niceworkkiimm-ai/gimbal-inspection-rover/THIRD_PARTY_NOTICES.md

# 第三方来源与许可

- `project/Library`：STMicroelectronics STM32F4 标准外设驱动。各文件保留原始版本、版权及 MCD-ST Liberty SW License 声明；请按原声明使用。
- `project/Start`：ARM CMSIS 与 ST 启动、系统和器件头文件；各文件内原许可证优先。
- `project/three.min.js`：Three.js Authors，文件内声明 MIT / SPDX-License-Identifier: MIT。
- `project/OrbitControls.umd.js`：Three.js OrbitControls 的本地 UMD 适配文件，按对应 Three.js MIT 许可理解；保留已有文件注释。
- Arduino ESP8266 Core 3.1.2、Arduino ESP32 Core 3.3.11 通过开发板管理器安装；本仓库不上传 Core 压缩包、编译器或 SDK 构建缓存，各依赖沿用其自身许可证。

仓库保留项目原有文件，并未宣称第三方驱动、字体、示例和网页库为原创。没有为整个混合项目新增统一的再授权许可证。
