niceworkkiimm-ai/gimbal-inspection-rover/docs/publication.md

# 首次公开整理记录

日期：2026-10-08。

## 范围

- 独立仓库 `niceworkkiimm-ai/gimbal-inspection-rover`，不使用工创仓库。
- 基于当前工作工程：STM32 V8.13、基座 ESP V4.9、NodeMCU 手持 V1.6、ESP32-CAM V1.2、网页 V8.12。
- 首次选择性同步收录 215 个源码/文档/必要资源文件，另生成 6 份公开密码配置示例。
- 保留原目录；逐文件校验选中原文件同步前后的 SHA-256 一致。包含个人路径的说明在公开副本中使用占位，旧 Git 历史不导入。
- 原源码中的 6 处 Wi-Fi 密码配置在发布副本中提取为未跟踪的 `secrets.h`，原件不改动。
- 排除编译产物、SDK 压缩包、IDE 状态、缓存、报告截图和私有配置；保留现有驱动与网页依赖的版权注释。
- 增加 README、依赖清单、开发对话/工程交接摘要，以及 D 盘一键同步备份工具。

## 验证

- 同步第二次执行为 0 变更，选中原文件哈希保持一致。
- Keil 完整重编译：0 Error(s)、0 Warning(s)。
- Arduino ESP8266 Core 3.1.2：基座、手持编译通过；Arduino ESP32 Core 3.3.11：AI Thinker 摄像头编译通过。
- ESP32 首次在中文构建路径下链接失败，改用 D 盘英文构建目录后通过；未因此修改固件功能代码。
- 现有扫描快照测试：7 passed、0 failed。
- 两个主要网页的外部脚本依赖存在，内嵌脚本及根目录 JavaScript 语法检查通过。
- 私有配置、密码头文件和生成的编译文件被 Git 忽略；发布脚本在提交前再次检查暂存区。

这次验证不执行硬件烧录，不代替实际供电、PCB 接线、运动方向、传感器或图传的实机测试。
