niceworkkiimm-ai/gimbal-inspection-rover/project/V7.1_路线记录与补传说明.md

# V7.1 路线记录与补传

更新日期：2026-09-12。STM32 V7.1，基座 ESP V4.7，手持端保持原版本。

## 这次解决什么

以前网页收到编码器数据后才计算路线，Wi-Fi 中断、浏览器暂停或基座重启可能让中间采样丢失。现在由 STM32 持续计算路线，网页按记录编号分批读取；短时断网恢复后，自动补回仍在缓存中的真实记录，不把未知路段简单画成直线。

- STM32 主循环至少间隔 40 ms 计算一次，至少间隔 80 ms 留一条记录。
- 内存保存最近 1024 条，按 80 ms 计算约 82 秒；实际覆盖时间随主循环采样间隔变化。
- 缓存满后覆盖最早记录。恢复通信和追赶积压也需要时间，不应把 82 秒当作保证可恢复的断网时长。
- 2D/3D 页面都支持，保存和打开仍用原来的按钮。雷达量程、方向、扫描点功能不变。
- 基座单独重启时，只要 STM32 持续运行且缓存未覆盖，仍可补传。
- 主控重启、缓存覆盖、主控采样异常仍明确留缺口，不能保证任何情况下路线都完整。
- 这只是编码器里程估算，不是定位建图；轮子打滑产生的误差不能靠补传消除。

## 更新哪些设备

1. 用本目录的 `Gimbal_STLink.uvprojx` 重新编译并烧录 STM32。
2. 用本目录的 `ESP01S_Base_UDP/ESP01S_Base_UDP.ino` 重新编译并烧录基座 ESP-01S。
3. 手持端不用重新烧录，所有接线不变，没有新增引脚，PD3 仍不接。
4. 重新打开本目录 `gimbal-radar-standalone.html` 或 `gimbal-3d-scan.html`。保留整个目录，不要单独复制 HTML；新增的 `route-log.js` 和原有脚本都需要一起保留。

上电后请核对网页标定：轮径 97 mm、左右轮中心距 202 mm、前后轮中心距 210 mm、每圈 374 次、四轮方向依次为 `+ - + -`，并确认标定。与固件不一致时网页拒绝接纳新路线，不能只在网页改尺寸就让固件跟着改变。

## 使用与保存

1. 连上基座热点，再打开网页；首次打开或点击重新记录，从当前位置开始，不追溯刚打开前的缓存路程。
2. 页面出现“车端记录已同步”后，手动驾驶记录路线。
3. 短时断网时保持页面打开，不刷新、不关闭、不重新记录。恢复连接后等待补传完成。
4. 停车，等待“车端记录已同步”，再点“保存路线”。首次保存选择桌面的“路径保存数据库”文件夹；不支持文件夹选择的浏览器需在下载记录确认文件，并放到该文件夹。
5. 之后可离线使用“打开路线”查看保存的 JSON。主控重启不会删除已经保存到电脑的文件。

主控缓存只是 RAM，不是永久数据库。网页刷新会丢失当前补传游标并开始新记录；主控断电会丢失其缓存。未保存的路线不能保证在关闭网页后恢复。

旧文件仍能打开，但本次更新无法找回旧文件已经缺失的实际路段。要自动复走，请重新记录完整路线；有缺口、会话重启或绘制简化的路线仍会被自动复走检查拒绝。

旧版基座没有新接口时，页面退回原编码器接收方式，可继续显示，但不具备这次新增的车端补传能力。

## 建议测试顺序

1. 四轮架空、车架固定，确认手动前后/转向和松手停车仍正常，观察编码器和 RPM。
2. 在空旷安全场地低速手控走短路线，停车保存，再打开，确认路径一致。
3. 保持手持端和基座连接，只让电脑断开热点约 10 至 30 秒，手控低速走一小段后停车。电脑重新连接，保持同一网页，等待同步完成，再检查并保存。
4. 可分别检查单独打开 2D、单独打开 3D、同时打开两个页面。两页各自有记录起点和补传进度，不要求显示坐标完全相同。

自动行驶仍受原有网页心跳、手持链路、主循环超时和前方测距保护。缓存能存约 80 秒，绝不意味着自动驾驶失联后允许继续行驶 80 秒。保护停车后不会自动恢复驾驶。

## 验证边界

已完成主控编译、基座编译，以及记录、缓存覆盖、断网重试、重复批次、会话切换、保存打开和控制保护的电脑模拟测试。测试不能代替实车验证；尚未替你烧录，也未实测主循环最大耗时、真实 Wi-Fi 丢包率或车辆循迹精度。
