niceworkkiimm-ai/gimbal-inspection-rover/project/V8.11_路线扫描点保存与回看.md

# V8.11 路线扫描点保存与回看

本次仅更新 2D/3D 网页。车辆路线上的红点保存停车位置对应的当前扫描点图，可点击回看，并随路线 JSON 一起保存和重新打开。

## 使用步骤

1. 在线连接车辆，停车并扫描到所需点图。保存前需有新鲜的路线和扫描数据，且原生路线记录同步完成。
2. 点击路线面板的“保存当前扫描点”，在当前路线位置生成红点。
3. 点击红点回看对应点图；3D 快照可旋转查看，两个页面均可打开。关闭回看窗口后继续查看现场。
4. 点击“保存路线”，将包含路线和扫描快照的 JSON 写入所选目录，或按浏览器提示下载。
5. 使用“打开路线”载入文件，恢复路线红点和点图，再点击红点回看。

2D、3D 页面均支持上述功能。打开历史文件后，点击“返回实时”可回到本次在线路线。

快照是保存时网页当前显示的扫描缓存，不是对“一次完整扫描已完成”的自动判定；保存前请确认画面就是需要保留的内容。3D 扫描会累积点云，到新点位后可先用现有“清空点云”再扫描；这不会删除已保存的路线红点。新红点先保留在浏览器内，关闭网页前请点击“保存路线”写入文件。

## 文件和范围

- 新路线 JSON 使用 `version: 2`，包含扫描快照；不保证旧版网页能读取新格式。
- 旧 `version: 1` 路线仍可打开，原文件没有的扫描快照不会被补造。
- 每条路线最多保存 100 个扫描点位，每点最多 800 个扫描采样；路线 JSON 文件上限为 20 MB。
- CSV 仍只导出路线，不包含扫描快照。
- 红点位置来自编码器路线估算，不是全局建图定位。该功能不包含气体或图传存档，也不恢复按保存路线自动行驶。

## 更新与接线

| 部分 | 本次版本 | 操作 |
| --- | --- | --- |
| 2D/3D 网页 | V8.11 | 替换网页及配套脚本后刷新 |
| STM32 | V8.10 | 无需烧录；`User/main.c` 仅更新顶部迭代注释 |
| 基座 ESP | V4.9 | 无需烧录 |
| 手持 NodeMCU | V1.6 | 无需烧录 |
| ESP32CAM_Camera | V1.2 | 无需烧录 |

已核对原固件接线，本次没有硬件改动。基座与 STM32 仍使用 **UART4：PC10 TX、PC11 RX，115200/8N1**；`User/main.c` 中完整接线表、供电说明及 `FIRMWARE_VERSION "V8.10"` 保持原样。电机、编码器、摇杆方向不变，无需重新标定实车方向。

## 验证范围

- Node 检查：7 组通过，覆盖快照独立副本、JSON 保存/打开、旧文件兼容、格式与容量边界、离线/未同步拒绝、重新开始。
- 浏览器本地模拟：2D/3D 捕获与回看、路线红点点击、3D 旋转、关闭/Escape、含快照文件保存、2D 页面断网打开并查看 3D 快照、返回实时和离线禁止新增均通过。
- 测试数据与测试文件写入服务仅在本机，未连接车辆；本次未进行实车验证或任何设备烧录。
- 可运行 `node tests/route-snapshot.test.cjs` 复查文件格式与数据边界。
