niceworkkiimm-ai/gimbal-inspection-rover/project/V8.5_图传10帧与上下翻转.md

# V8.5 · 图传10帧与上下翻转

更新：2026-09-13。摄像头V1.2；2D/3D网页V8.5。STM32 V8.2、基座ESP V4.8、手持V1.2不变。

## 怎么更新

1. 在Arduino IDE重新打开同一个 **ESP32CAM_Camera/ESP32CAM_Camera.ino**，防止IDE里仍留着旧内容。
2. Board保持 **AI Thinker ESP32-CAM**，Flash Mode=DIO、Flash Frequency=40MHz、Partition Scheme=Huge APP。接线与上次成功烧录时一样。
3. 点击 **Upload**，上传完成后IO0松开，按一下RST。只烧录摄像头，不烧STM32、基座或手持端。
4. Serial Monitor选115200。开头应显示 **Rover camera V1.2 / ESP32-CAM / QVGA / max 10 fps**。
5. 上下翻转日志 **Vertical flip requested: 1; result: 0 (0=OK); horizontal mirror: 0** 表示驱动接受配置；仍要对照实物确认方向。
6. 刷新原工程的gimbal-radar-standalone.html或gimbal-3d-scan.html，确认版本V8.5。图传窗口位置不变。
7. 关闭画面后，帧率选 **10 帧/秒**，再开启。原来已保存的5或3帧偏好不会被清除；首次使用默认10帧。摄像头地址继续用当前串口Camera URL。
8. 摄像头自己的独立查看页也支持10/5/3帧，并显示V1.2。一个窗口开启视频即可。

摄像头依赖文件CameraConfig.h、CameraHome.h继续与ino放在一起。网页的camera-panel.js继续与HTML放在同一个文件夹，不要只复制HTML。

## 改了什么

- 摄像头限速从200ms改为100ms，上限10帧/秒；/status的maxFps同步为10。
- 两页共用窗口及独立页面新增10帧选项，保留5/3帧。
- 10帧档网页至少105ms请求一次，留调度余量，理想情况下约9.5帧/秒，实际受曝光、信号、传输和解码耗时影响；不是保证稳定10帧。
- 摄像头CAMERA_VFLIP从0改为1，只上下翻转。CAMERA_HMIRROR仍为0，左右不变。不在网页做第二次翻转。
- 分辨率仍320×240，JPEG质量18；摄像头接线、热点、Arduino板型不变。
- 单查看者、每次只取一张、默认关闭、超时/过期清空、后台关闭机制保留。慢的时候等待本次完成，不积压请求追赶帧率。
- 摄像头固件版本1.2，HTTP接口版本仍1.0，原协议兼容。
- 主函数开头版本与接线复核说明已更新；全部电源、TFT、MPU、手持、基座、电机、编码器及传感器实际接线保留。
- 小车、云台、气体数据、路线记录/复走等控制代码不变。

## 使用提醒

帧率变高会增加共用ESP8266热点的流量，并不保证遥控更快。先停车检查画面方向，再有人看护下低速对比。手控变卡就先停车、关闭画面，降到5或3帧后重试。提高帧率不等于降低所有端到端延迟，也不新增自动停车功能。

## 电脑验证

- Arduino-ESP32 3.3.11 / AI Thinker ESP32-CAM正式编译与链接通过，未报告警告或错误。
- 应用1,058,629字节，全局变量59,832字节；不是运行时内存用量。
- 静态核对：STM32执行代码、实际硬件接线及两个网页的扫描逻辑不变；仅图传配置与版本更新。
- 已完成两页电脑/手机及独立页面的模拟JPEG收图回归：10帧默认项、启停、单请求、占用/限流、错误接口、重复/过期/损坏帧、超时、后台关闭通过。
- 2D、3D、独立页面各10/5/3帧共9组频率检查通过，历史帧率偏好保留正常；模拟350ms慢请求时始终只有1个请求在途，没有补发积压。详见D盘缓存测试结果。
- 未自动烧录。上下翻转的实际方向、真实10帧档表现、与手控共用热点时的稳定性仍需设备测试。

接线与Arduino操作详见V8.4_ESP32-CAM烧录与接线.md；其中V1.1和5帧数值为旧版记录，以本说明及当前源代码为准。研究、编译、测试缓存放在D盘，不需要用其中的工具来烧录；用户继续只用Arduino IDE。
