niceworkkiimm-ai/gimbal-inspection-rover/project/ESP32S3_Camera/历史版本_当前实物不要烧录.md

# 当前实物不要使用此文件夹

2026-09-13 已根据照片及烧录器识别确认：用户实物为普通 ESP32-CAM（ESP-32S），烧录底板为 ESP32-CAM-MB / CH340C。

本文件夹为此前依据 ESP32-S3CAM 资料生成的历史源码和固件，目标芯片及摄像头引脚不匹配，不能烧进当前板子。不要使用强制忽略芯片型号的参数。

请返回上一级，打开 **ESP32CAM_Camera/ESP32CAM_Camera.ino**（摄像头 V1.1），Arduino 的 Board 选择 **AI Thinker ESP32-CAM**。完整说明在 **V8.4_ESP32-CAM烧录与接线.md**。
