niceworkkiimm-ai/gimbal-inspection-rover/project/V8.14_模拟演示与录屏.md

# V8.14 巡检小车模拟演示

本功能用于展示网页的行驶轨迹、停车扫描与点图回看流程。路线、测距、轮速和气体均为程序生成的模拟数据，不代表现场实测。演示不连接基座或摄像头，也不发送车辆控制指令。

## 打开方式

双击同目录的 **巡检模拟演示.html**，或者打开原来的 **gimbal-3d-scan.html**，点击右上角 **模拟演示**。保留整个文件夹，各脚本和模型文件需要在同一目录。

进入后点击 **开始演示**。完整过程约 **2 分 13 秒**，累计路线约 **13.15 米**，小车依次经过五个扫描点后回到起点。

1. 双侧通道：左右墙面和地面。
2. 转角墙面：前墙与侧墙形成的转角。
3. 台阶障碍：逐级升高的台阶和低矮障碍。
4. 碎石区域：高低不同的模拟石块与远处墙面。
5. 柱体通道：圆柱障碍和侧墙。

每个点停车扫描约 10 秒，云台转动、点云逐步出现，完成后路线图上增加一个红色扫描点。行驶时轨迹、朝向、累计里程和四轮轮速同步变化；停车扫描时轮速归零。

## 播放和回看

- **开始／暂停演示**：控制播放；**从头开始**重新生成本次演示过程。
- **进度条**：拖动到任意时刻，路线和已保存扫描点随进度同步变化。
- **播放速度**：支持 0.5×、1×、2× 和 4×。
- **五个场景按钮**：跳到对应扫描完成的位置并打开点图。
- **路线红点、扫描点下拉框、查看点图**：沿用原有回看操作。
- **点图窗口**：拖动旋转、滚轮或双指缩放；打开点图会暂停演示，关闭后按“开始演示”继续。
- **退出演示**：返回原来的实测网页。

## 录制展示视频

电脑推荐 1920×1080 分辨率，浏览器最大化。默认开启 **录屏布局**，将三维扫描与路线放在同一屏幕内。按 F11 可进入浏览器全屏。

先开始录屏，再点击“开始演示”。可以保持 1× 展示完整过程，或者用 2× 缩短行驶时间。在几个停车点暂停，点击对应红点展示不同地貌，再继续播放。录屏画面保留“模拟演示／非实测数据”标识。

浏览器窗口较小或希望使用原来的宽松布局时，可以关闭“录屏布局”。手机也能打开和回看点图。

## 保存和重新打开

**下载完整模拟路线** 可以导出包含五个扫描点的完整 JSON，不必等待播放结束。文件夹内也提供 **模拟数据_完整巡检路线_五个扫描点.json**。

原来的“保存路线”可以保存当前进度。“打开路线”能重新打开模拟 JSON；三维页或二维页均能读取。文件、路线状态和点图窗口会保留模拟数据标记，扫描点名称也会保留。CSV 路线及轮速导出同样带有模拟标识。

## 实现与验证边界

扫描点由射线与预设墙面、台阶、椭球形石块、圆柱相交计算生成，加入确定性的微小扰动。各个场景包含不同的几何形状，不是同一组随机散点。沿用现有小车模型、点云坐标投影、颜色和轨迹回看组件。

只更新网页功能；STM32、基座、手持和摄像头固件无需重新烧录。真实路线、浏览器已有标定和控制程序不因进入演示而修改。网页版本 V8.14；原二维页面主体仍为 V8.12，共用脚本已更新缓存版本。
