niceworkkiimm-ai/gimbal-inspection-rover/project/V6.1_小车架空试转说明.md

# V6.1 小车架空试转

> 历史说明：当前程序已更新为V6.2，PWM上限30%，右侧2/4轮输出极性已修正，回中范围改为8度；以V6.2说明和User/main.c开头注释为准。

更新日期：2026-09-07。仅修改新版工程中的STM32代码，未自动烧录。

## 本次修改

- 解除原来的CAR:LOCK配置锁，最大PWM占空比由35%降为15%。
- 按用户要求移除未安装的PD3急停输入：PD3不接，不需要接地跳线。
- 保留250ms输入失联停车、回中确认、手持按键软件停车、超限倾角停转、渐变输出、100ms换向停顿、主循环超时及异常PWM归零。
- 未更改手持或基座ESP程序、通信协议，也未修改雷达网页及其他外设功能。
- 15%是PWM占空比，不是实际速度或电流限制。未声明轮向、电流、硬件急停已经通过实物验收。

## 接线

| 轮号 | 位置 | PWM | DIR |
| --- | --- | --- | --- |
| 1 | 左前 | PC6 | PC4 |
| 2 | 右前 | PC7 | PC5 |
| 3 | 左后 | PE5 | PB12 |
| 4 | 右后 | PE6 | PB13 |

驱动板与STM32共地；每路PWM输入保留约10kΩ下拉。PD3不接。
电机电源电压、电流须符合实际电机和驱动规格，保留保险和可直接切断电机电源的办法。
完整的屏幕、手持端、基座ESP、气体、超声波、语音、灯带、舵机及烧录接线在User/main.c开头，除PD3取消外均未变。

## 烧录与试转

1. 电机电源先关闭，在当前工程打开Gimbal_STLink.uvprojx，目标选择Gimbal STLink。
2. Rebuild后Download到STM32。只需要烧录STM32，不需要更新两个ESP。
3. 保持四轮架空、车架固定、轮边无人手或散线。上电时手持端放平，默认云台模式不会驱动小车。
4. 短按D5切到小车，保持水平约1秒。STM32要求至少10个不同的新数据包且持续回中约0.4秒，手持端也需就绪。正常会由LEVEL变为READY，而不是LOCK。
5. 轻微前后倾测试前进/后退，左右倾测试原地转向；倾角越大PWM越大，最多15%。回中、切回云台或按住手持键会撤销运动输入，长按约0.8秒进入保持的软件停止模式。
6. 首次逐一核对1/2/3/4轮向。若某轮反向，停止并断开电机电源，再调整CarConfig.h中的对应CAR_Mx_SIGN。实物方向未检查前不要落地测试。

低占空比可能不足以克服静摩擦，表现为嗡鸣但不转；这种情况先停止，不要长时间堵转，也不要盲目加电压。
本版没有硬件急停输入。软件停止依赖主控、通信或中断正常工作，不能保证故障情况下都能停机，更不等于机械瞬间停止。

软件测试和编译不代表完成实物试转；实物检查由用户在架空固定条件下进行。
