niceworkkiimm-ai/gimbal-inspection-rover/project/V8.9_保留路线保存_删除自动行驶.md

# V8.9：保留路线保存，删除自动行驶

更新日期：2026-09-15。

## 本次修改

- 保留实时路线绘制、保存路线、打开历史路线、返回实时，以及断网后的车端路线补传。
- 不修改、移动或删除桌面“路径保存数据库”内的已有文件；原JSON格式保持兼容。
- 删除2D/3D的“按路线行驶”、自动行驶停止按钮、状态提示与自动车辆位置叠加。
- 删除STM32自动驾驶状态机、路线上传/执行/心跳协议，以及强制云台回正占用逻辑。
- 基座旧“/api/route”接口返回410，不再转发驾驶指令；“/api/route-log”只读记录接口保留。
- 保留云台自动扫描、体感云台、体感小车、摇杆小车、气体/距离/轮速显示和图传。
- 手动速度上限、回中确认、失联停车、换向等待和编码器方向不变；全部接线不变。

## 使用

1. STM32：在此目录打开Gimbal_STLink.uvprojx，执行Rebuild，再下载V8.9。
2. 基座ESP-01S：用Arduino打开ESP01S_Base_UDP/ESP01S_Base_UDP.ino并上传V4.9。
3. 关闭旧网页，重新打开此目录gimbal-radar-standalone.html或gimbal-3d-scan.html，确认V8.9。
4. 手持NodeMCU仍用V1.5；摄像头仍用V1.2，都不用重烧，也不用改线。
5. 若直接下载HEX，可使用本目录固件/V8.9/Gimbal_STLink_V8.9.hex。

代码编译不等于设备已更新；本次未代替用户烧录或进行实车运行测试。

## 连接卡顿：检查结论与边界

本次只移除自动行驶，未修改网络超时、图传帧率或其他通信参数。

从现有代码确认：

- 基座ESP8266在同一个loop里执行手持UDP转发和网页server.handleClient()。
- 本机安装的ESP8266 3.1.2网页库将HTTP_MAX_SEND_WAIT设为5000ms，发送响应可能等待网络接收。期间网络底层仍可能运行，但应用中的手持转发不能按平时频率执行。
- 3D遥测轮询周期80ms，2D为100ms，各自还有独立路线补传请求。两页同时打开会叠加请求。
- 摄像头直接向网页提供JPEG，不通过STM32串口或基座HTTP转发，但连接同一个基座热点，仍共享无线空口。10帧/秒、多页面或较差信号可能加重竞争；这些并非已证实的本次唯一原因。
- 超声波等待采用回绕安全的周期差值，两段超时分别20ms和25ms。它会贡献几十毫秒的主循环等待，但不足以单独解释稳定1至2秒的反应延迟。
- 能连接热点仅说明Wi-Fi已关联，不代表应用数据正在及时转发。

本次从电脑访问192.168.4.1未获得响应，未采集到故障发生时的设备运行日志；因此不能把上述风险当作已实测定位，也不能承诺删除自动行驶就会消除卡顿。

建议先固定条件比较：轮子架空或断开电机动力电源，关闭所有视频与其他控制页面，只留一个网页；若仍卡顿，再关闭网页，仅测试手持云台。随后分别开启单页、3帧图传、10帧图传观察。

若关闭网页/视频后仍延迟，再检查基座3.3V供电、距离/天线干扰、手持I2C状态与STM32调度；不要仅靠提高超时掩盖问题。

## 软件验证

- STM32 Rebuild：0错误、0警告。
- 基座ESP编译通过；未改动的formatScaled函数触发1条格式化宽度警告。接收处已将decimals限制为0至3，本次未修改气体解析与格式化。
- 已验证路线记录/补传、计数回绕、原地转向、方向校验、手动控制及失联/停车保护。
- 浏览器模拟验证2D/3D保存、重新打开、断网查看、跨页面文件兼容、补传和手机布局；这些不等于实车无线性能测试。
- 备份、日志和测试输出：D:\礼堂缓存\remove-auto-v89-20260915。
