niceworkkiimm-ai/gimbal-inspection-rover/project/TFT_引脚接线参考.png

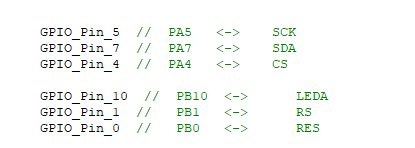
project/TFT_引脚接线参考.png
