niceworkkiimm-ai/gimbal-inspection-rover/project/web-dashboard/desktop-preview.png

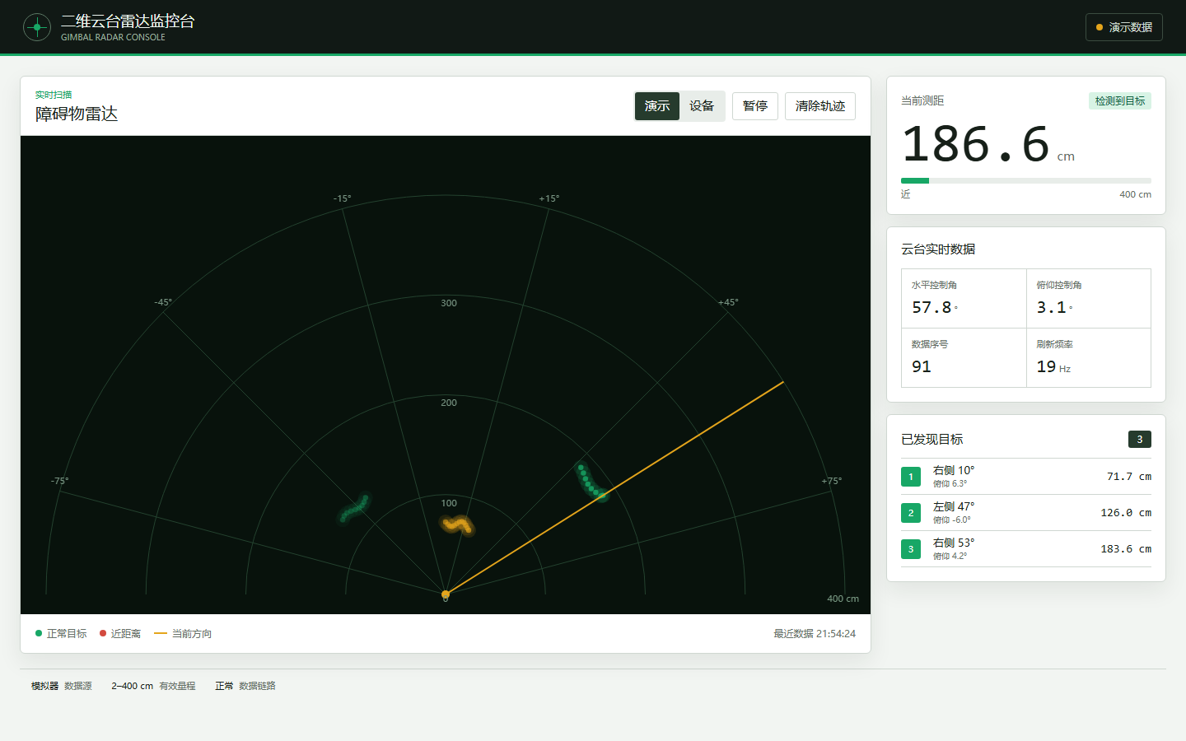
project/web-dashboard/desktop-preview.png
