niceworkkiimm-ai/gimbal-inspection-rover/project/web-dashboard/mobile-preview.png

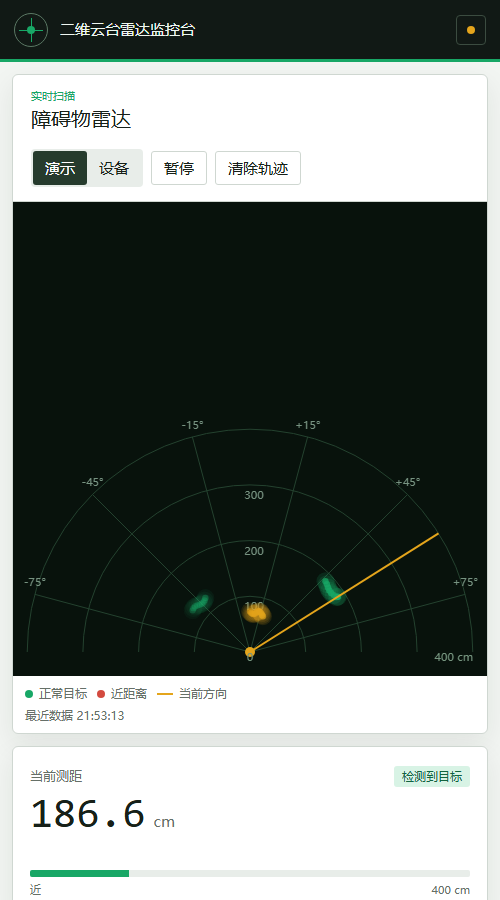
project/web-dashboard/mobile-preview.png
