niceworkkiimm-ai/gimbal-inspection-rover/project/Hardware/WheelEncoder.h

#ifndef WHEEL_ENCODER_H
#define WHEEL_ENCODER_H
#include "stm32f4xx.h"
#include "EncoderProtocol.h"
void WheelEncoder_Init(void);
void WheelEncoder_Snapshot(EncoderFrame *frame, uint32_t sequence);
#endif
