niceworkkiimm-ai/gimbal-inspection-rover/project/NodeMCU_Handheld_MPU_Car/HandheldOledFont.h

// Handheld V1.4: fixed OLED label bitmaps rasterized from Windows SimSun.
// Row-major masks, bit (width - 1 - x) is the left-to-right pixel.
#ifndef HANDHELD_OLED_FONT_H
#define HANDHELD_OLED_FONT_H
#include <stdint.h>
#include <pgmspace.h>
struct OledGlyph { uint16_t code; uint16_t rows[16]; };
static const OledGlyph kOledFont12[] PROGMEM = {
  {0x4E0D, {0x0FFE,0x0020,0x0020,0x0040,0x00D0,0x0148,0x0244,0x0C42,0x0040,0x0040,0x0040,0x0000,0x0000,0x0000,0x0000,0x0000}}, // 不
  {0x4E24, {0x0FFE,0x0110,0x0110,0x0FFE,0x0912,0x0912,0x0AAA,0x0C46,0x0882,0x0802,0x0806,0x0000,0x0000,0x0000,0x0000,0x0000}}, // 两
  {0x4E2D, {0x0040,0x0040,0x0040,0x07FC,0x0444,0x0444,0x0444,0x07FC,0x0444,0x0040,0x0040,0x0040,0x0000,0x0000,0x0000,0x0000}}, // 中
  {0x4E91, {0x03F8,0x0000,0x0000,0x0000,0x0FFE,0x0040,0x0080,0x0110,0x0208,0x07FC,0x0004,0x0000,0x0000,0x0000,0x0000,0x0000}}, // 云
  {0x4F20, {0x0110,0x0110,0x02FC,0x0220,0x0620,0x0BFE,0x0240,0x027C,0x0204,0x0268,0x0218,0x0204,0x0000,0x0000,0x0000,0x0000}}, // 传
  {0x4F4E, {0x010C,0x01F0,0x0290,0x0290,0x0690,0x0AFE,0x0290,0x0290,0x02AA,0x02CA,0x02A6,0x0212,0x0000,0x0000,0x0000,0x0000}}, // 低
  {0x503C, {0x0220,0x02FE,0x0420,0x04FC,0x0C84,0x04FC,0x0484,0x04FC,0x0484,0x04FC,0x0484,0x05FE,0x0000,0x0000,0x0000,0x0000}}, // 值
  {0x505C, {0x0110,0x01FE,0x0200,0x027C,0x0644,0x0A7C,0x0200,0x02FE,0x0282,0x027C,0x0210,0x0230,0x0000,0x0000,0x0000,0x0000}}, // 停
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
  {0x8BF7, {0x0040,0x4040,0x27FC,0x2040,0x03F8,0x0040,0xE7FE,0x2000,0x23F8,0x2208,0x23F8,0x2208,0x2BF8,0x3208,0x2228,0x0210}}, // 请
  {0x8F66, {0x0200,0x0200,0x0200,0x7FFC,0x0400,0x0900,0x1100,0x2100,0x3FF8,0x0100,0x0100,0xFFFE,0x0100,0x0100,0x0100,0x0100}}, // 车
};
#endif
