niceworkkiimm-ai/gimbal-inspection-rover/(commit log)

2026-10-25 fix: rotate ESP32-CAM image 180 degrees from v1.2
2026-11-11 fix: preserve tilt drive range and recover from UART faults
2026-11-11 fix: keep base telemetry independent of camera hostname resolution
2026-11-12 feat: show CAD rover and animate each wheel from encoder speed
